ZBC-QRLA/QRLA/README.md

# QRLA

这是重庆大学CRTC(2026） **QRLA战队** 的备赛文档仓库。

>这里记录我们从那天被几个战队拒绝后的心气组队到努力备战希望通过中期考核的尝试，希望我们能够通过，得到报销，然后走得更远，后面或许还能记录我们完整的参赛历程。 

## 队伍介绍

|  |  |
| --- | --- |
| 队伍名称 | QRLA |
| 参赛赛事 | 重庆大学CRTC(2026) |
| 参赛组别 | 新生组 |
| 实训战队 | 千里战队 |
| 队长 | 曾斌才 |
| 队员 | 苏古家乐、安文豪、李志杰 |

**分工：**

| 角色 | 成员 |
| --- | --- |
| 队长 | 曾斌才 |
| 电控 / 硬件 | 苏古家乐、曾斌才 |
| 机械 | 安文豪、李志杰 | 

## 文档索引

所有文档均按**机器人设计进度的完成时间点从早到晚**排列(可能是一天/一个任务的一段时间)

| 序号 | 文档 | 阶段 | 内容提要 |
| --- | --- | --- | --- |
| 01 | [第一天：环境搭建与工具链配置](docs/start-first-day.md) | 起步 | 队伍分工；学生邮箱与 JetBrains 教育许可；CLion + STM32 工具链配置；机械组fasion安装；非常懵懂地努力的几个小时 |
## 机械建模的建模文件在docs/machine
<span style="color:#888;font-size:12px;">这个格式真的好难调，对着豆包打，少一个空格就弄不出来，还好手机像素够高（本备注写于第二天喵）</span>
