ZBC-QRLA/QRLA/docs/机械组工作报告.md

# 机械组学习&工作报告

## 一.机械设计环境搭建

日期：10月2日至10月7日

1.**活动目的**：完成3D设计的软件下载并构建一个高效、规范、协同且安全的数字化设计工作平台，让设计工作能稳定、高质量地开展，同时完成软件常用功能的学习，为后面3D设计机械臂及整车的模型设计打下基础。

2.**预期过程**：3D设计环境搭建→草图功能学习→二维到三维转变的功能学习→装配体功能学习→简单零件的建模跟练。

3.**预期结果**：能够根据实体进行建模，能完成装配体的动画演示。

**活动历程**：

1.Fusion360的安装: 对比了多款主流的3D建模软件选择了Fusion360并进行安装。原因：Creo / NX / CATIA更适用于高端复杂场景，SolidWorks作为最稳妥的主流选择。钣金模块成熟直观，折弯系数、展开图生成都很准，但是价格较高且云端协作能力差，不方便队友之间实时共享进度，Fusion 360的个人非商业用途免费，安装简单，集成了CAD/CAM，对新手友好。

>遇到问题：教育许可版本申请不下来且咨询学长并根据各平台教程多次申请未果。

>解决方法：选择个人非商业用途版并在后期调试时确定其可以满足本次赛事需要。

2.Fushion360的功能学习：根据b站博主“罗大富Bigrich”的教程学习，掌握草图绘制的技巧，能灵活使用中心矩行，两点园等，基本掌握参数化建模和对成品的修改，学会简单的装配联接。Q：如何快速创建齿轮？  A：在实用程序的附加模块中选择Super Gear，然后在创建中找到它并调整参数。

3.跟练：从简单立方体到曲面体的建模跟练，基本可以根据实物独立建模。

>潜藏问题：
>
>- 仅停留在软件学习程度，对比赛的要求了解不全面没有考虑CRTC机器人尺寸、球体包络规则约束。
>
>- 对实体材料缺少了解，不确定3D打印能否打印螺纹。
>
>- 没有了解舵机的工作原理，没有给舵机预留孔位的意识。（这一点是在10月115日意识到的）

当时规划的计划：

- 与电控和硬件的同学商议小车的大体外形，确保小车的尺寸和重量在规则要求的范围内。

- 继续学习机械制造的材料如何选择，学习机械组装所需要的工具和相关力学知识以保证后期小车的稳定性和可操作性。

## 二、机械臂设计初步方案

时间：10月7日

提出方案：

方案一：参考2025年工创赛的比赛视频，提出让底座不动，大臂，小臂，夹子动，同时通过小臂360度转动实现将能量方块从拾取到放入机械臂后的储物框的过程。

方案二：减小小臂的旋转度数，让底座旋转，达到和方案一同样的效果。

方案三：将储物筐置于机械臂之前，底座不转动，延长大臂和小臂完成取物和放入框中的动作。

确定方案：

与队友协商后确定用方案二建模。  
>**原因**：方案一对供电安全和舵机精度要求高，舍弃；方案三因为考虑到要拾取地面上的物块，所以对于两臂的长度和两者之间的夹角要求高，需要在车架和储物框都确定后进行测量，综合考虑后，暂定方案二。

## 三、车架设计

时间：10月8日至10月18日

车架安装遇到的问题及解决——在tt马达与麦轮到手之前，我先在网上参考智能小车安装视频，对安装步骤做到心中有数。到手将tt马达与麦轮安装到底盘上之后，发现麦轮与马达之间的连接并不紧密，于是跟商家要了tt马达与麦轮的建模图分析内部结构，发现问题的根源是与麦轮配套的螺丝(M3*25）过长导致，在更换螺丝(M3*20）后，麦轮与马达连接紧密，问题得到解决。

## 四、机械臂设计

时间：10月8日至今

1.目的：实现从地面到距地面300mm处的边长为30mm的镂空立方体的夹取并平稳放入储物框。

2.预期过程：3D打印材料和钣金的选择使用→根据底盘确定底座尺寸→第一次受力分析明确大臂和小臂的分布和两者之间的比例→夹爪的设计→连接关节的设计→机械臂的二次受力分析及减重设计→动画演示→成品试验与迭代

3.预期目标：①Fusion360完成全部零件实体建模，建立装配体，做干涉检查，保证运动时零件不碰撞。

②运动仿真验证：底座旋转、小臂抬降、夹爪开合（张开角度为180度）三个动作无结构卡死；导出各零件3mf用于切片打印。

③能够完整完成一次质量为12.071g的镂空立方体的抓取、搬运、释放。

**活动历程**：

>**第一次设计(10月8日至10月15日)**

· 圆形底座：位于最下方，作为整个机械臂的安装基础，含有第一轴并负责负责整个机械臂在水平面上的左/右旋转（腰部转动），内部预留MG995舵机安装空位。

· 肩部关节：连接底座和主臂，内部包含第二轴。控制大臂的俯仰（前后倾倒）动作。

· 大臂：呈弯曲状的粗壮连杆。做成流线型、内凹的设计来实现保证结构强度的同时减轻重量（拓扑优化），并避开自身的干涉。

· 肘部关节：连接大臂和小臂，对应第三轴。控制小臂的上下俯仰，决定了机械臂的伸展高度。

· 小臂：较直的一段管状半封闭结构。小臂内部留走线空间。

· 小臂旋转：在小臂的末端（靠近手腕处）有一个关节，负责整个手腕部分沿小臂轴线的自转。

· 手腕：图中的灰色紧凑关节包。包含第五轴（俯仰）和第六轴（末端自转）。多轴联动使得末端能够以任意姿态到达空间中的某一点。

· 末端执行器：做平行夹爪结构。它由两个对称的机械手指组成，通过外部的驱动机构实现平行开合，用来抓取方块。

设计问题：①设计时过分考虑减重导致肩部没有给舵机预留出足够的空间。

②整个机械臂需要起码5个舵机来实现各关节的灵活运动，超出规则要求。

③将夹子和能量方块打印出来后发现架子设计的过小，即使做了增大摩擦的处理也无法顺利夹起物块。

由于第一版机械臂问题过于严重，选择推翻重做。

>**第二次设计（10月15日至18日）**

· 基座：最下方是一个方形底板，方形空腔（放MG995）及圆柱形盖子做第一关节（腰部旋转），方形侧边均做圆角处理，减少碰撞磨损的可能。

· 肩部：连接底座圆盘和大臂的深灰色“U型”支架，较厚实，承受了整个大臂和小臂悬伸带来的巨大弯矩，同时留有MG995的安装空间。

· 主臂（大臂与小臂合一）：这是一根单连杆。这大大简化了结构，但也限制了灵活性（受舵机数量限制）。

·腕部：放置MG90，做与夹爪之间的联接

·夹爪：一个设计得相当紧凑的齿轮联动式平行夹爪。可拆解为三个核心部分：驱动基座、传动机构和执行手指。

1. **驱动部分**

>· 小齿轮套在MG90上，作为主动轮。

2. **核心传动机构**

>· 从动轮（大齿轮）：位于正中央。它接收来自小齿轮的旋转动力，它起着“惰轮”的作用，当小齿轮受舵机带洞转动时，它会直接带动与其以榫卯结构结合的左夹爪。因为右侧有一个惰轮，这就使得左右两个夹爪的旋转方向是相反的。一开一合，实现了夹取动作。

>·次从动轮（夹爪上的齿轮）：。当大齿轮旋转时，通过这个小齿轮，改变了动力的输出方向，使得两根夹爪的手指能够实现同步反向运动。

3. **执行手指**

·主体是对称的两个半个篮子，闭合后内部为40mm×32mm的框，侧边均做倒角和圆角处理，便于通过开合实现对立方体的拾取和放下。如图1

潜藏问题：1.齿轮过多，可能导致扭矩过大，需等待具体试验测试。

## 收集框设计思路历程

### 一、需求分析：先明确收集框要满足什么

设计初期，我先没有直接画收集框，而是从赛规、机械臂（已设计好）、物品和车体安装四个方向反推约束。

1. 赛规与车体约束

收集框外廓初定为 110×110×80 mm，投影尺寸控制在车体允许范围内，避免超宽、超高，不能干涉轮系、传感器和机械臂运动。

2. 物品适配需求

收集物品为 30×30×30 mm 立方体，框子内腔必须能容纳整数个物品，并且物品不能从侧壁缝隙或底部漏出。

3. 机械臂适配需求

框口要位于机械臂末端可达范围内，顶部全开口，高度与机械臂大臂相协调，方便机械臂底座从左右两方旋转过程中抓手不会被收集框卡住。

4. 安装与维护需求

收集框通过 M3 螺钉与车体连接，要求拆装方便、孔位统一、维修更换简单。

5. 轻量化与强度需求

小车对重量和重心敏感，框子不能做成实心封闭盒。采用“底板+四侧壁”的开放框结构，减轻重量。

6. 制造需求

使用3D 打印，壁厚统一，在建模设计时特意增大螺孔直径，设为3.2mm，避免打印缩孔后装不上。

### 二、尺寸计算：按 3 cm 物品重新核算

1. 外形与内腔

取外尺寸：

· 外形：110×110×80 mm

· 侧壁厚：4mm

· 底板厚：4mm

2. 容量计算

物品为 30 mm*30mm*30mm的 立方体。

预估共可收集18个立方体。

### 三、结构设计：框子的具体组成

最终结构分为三部分：

1. 底板与四侧壁

厚 4 mm，四角布置 M3 安装孔，与底盘对应孔位相一致。四条棱做R5圆角。

2. 顶部框口

顶部全开口，开口约 106×106 mm，边缘做R5圆角。

3. M3 安装接口

M3 通孔 Φ3.2，沉孔 Φ6.4。孔位做成参数化阵列，方便根据车体底板孔位微调。

### 四、建模与验证思路

建模顺序：

1. 先画 110×110×80 mm 外框参数化草图。

2. 抽壳得到 4 mm 侧壁、4mm 底板。

3. 四角根据底盘现有孔位，测量数据，确定螺孔位置。

4. 做 R5圆角。

5.装配检查机械臂末端包络是否覆盖框口、框体是否与车体/轮系/传感器干涉、M3 螺钉是否可拧入。

6. 导出 STL 前检查最小壁厚、孔是否被圆角吃掉、螺母位是否可安装。

### 五、总结

我的收集框设计思路是：以 110×110×80 mm 外廓满足车体与赛规约束，以 102×102×776mm 内腔保证 3 cm 立方物品的容量，按每层 3×3、两层共 18 个理论容量设计，实际按 15～18 个验证。
