ZBC-QRLA/QRLA/docs/files/一个合理的工具链配置流程 .pdf

# 一个合理的工具链配置流程

（本文仅针对重庆大学CRTC2026校内赛撰写）

## 一些问题

当你准备接触嵌入式，参加校内比赛或是自己做一些东西时候，可能会选择向有经验的高年级同学选 择求助，除了部分愿意帮助你进行线下配置的大好人，大部分高年级同学还是倾向于选择甩一个b站链 接或者直接让你搜索相关视频，例如：
•
Keil v5+MDK-ARM注册机破解教程
•
Visual Studio Code与Keil工具链配置教程
•
STMCubeIDE配置教程

然后就让大家自己去尝试学习配置相关软件时，更多时候作为一个新入学的嵌入式新人，在你过去十 几年求学生涯中，90%的人可能并没有被引导学习过相关的知识，于是必然需要头铁去啃那些的视 频，更不必提用百度网盘，QQ群文件等下载一堆来路不明的软件。就我个人看来，这种方式是极其不 合理的，虽然在一定程度上筛选了一批对于PC操作不敏感的学生，但是也断绝了一部分对于理论设计 有意识的人的热情。

因此为了抹平配置问题这一壁垒，对于重庆大学千里战队的梯队成员，抑或是参与校内相关比赛前来 学习的非队员同学甚至是校外人士，我们立志提供一份有别于网络上其他同质化教程的快捷配置方 案。

## 一套办法

作为一名合格的大学生，通过正规手段获取生产工具是一项必要的技能。

也许大家看过诸如“付费解锁”“限时秒杀”WinRAR， VScode等软件的梗图，但是在这里我们一定 要达成的共识是，本科阶段学习过程中你使用到的90%的工科软件都有免费获取的途径，因此在下文 我们会引导大家怎么去下载这一内容。

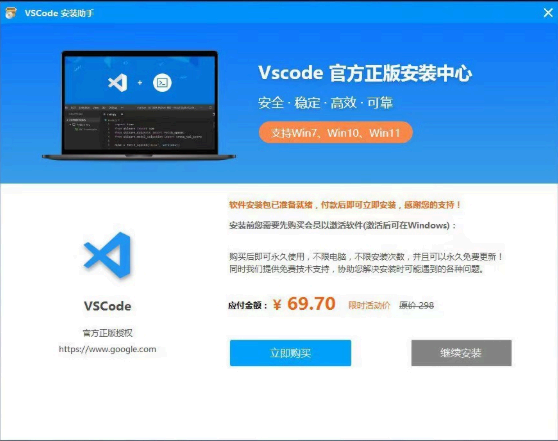
[picture p1: figure]

## 注册重庆大学学生邮箱

作为重庆大学的学生，带有“学号+stu.cqu.edu.cn”格式的官方学生邮箱是能够辅助证明学生资质的

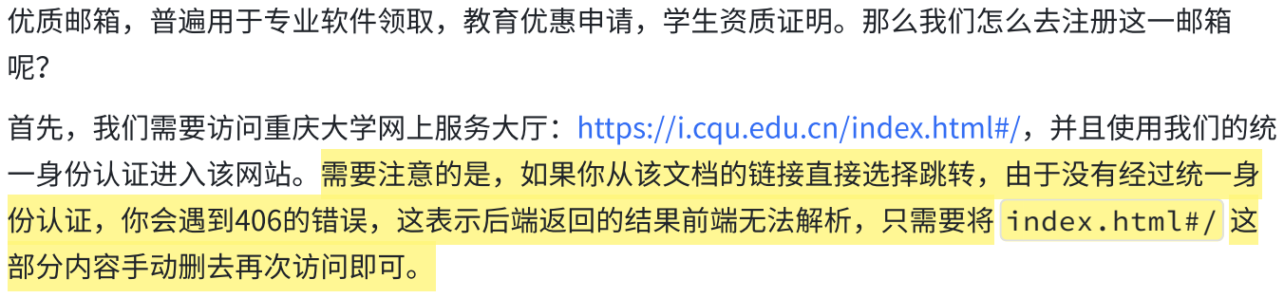
[picture p2: figure]
优质邮箱，普遍用于专业软件领取，教育优惠申请，学生资质证明。那么我们怎么去注册这一邮箱; 首先，我们需要访问重庆大学网上服务大厅：https://i.cqu.edu.cn/index.html#/，并且使用我们的统; 一身份认证进入该网站。需要注意的是，如果你从该文档的链接直接选择跳转，由于没有经过统一身; 份认证，你会遇到406的错误，这表示后端返回的结果前端无法解析，只需要将; index.html#/; 部分内容手动删去再次访问即可。
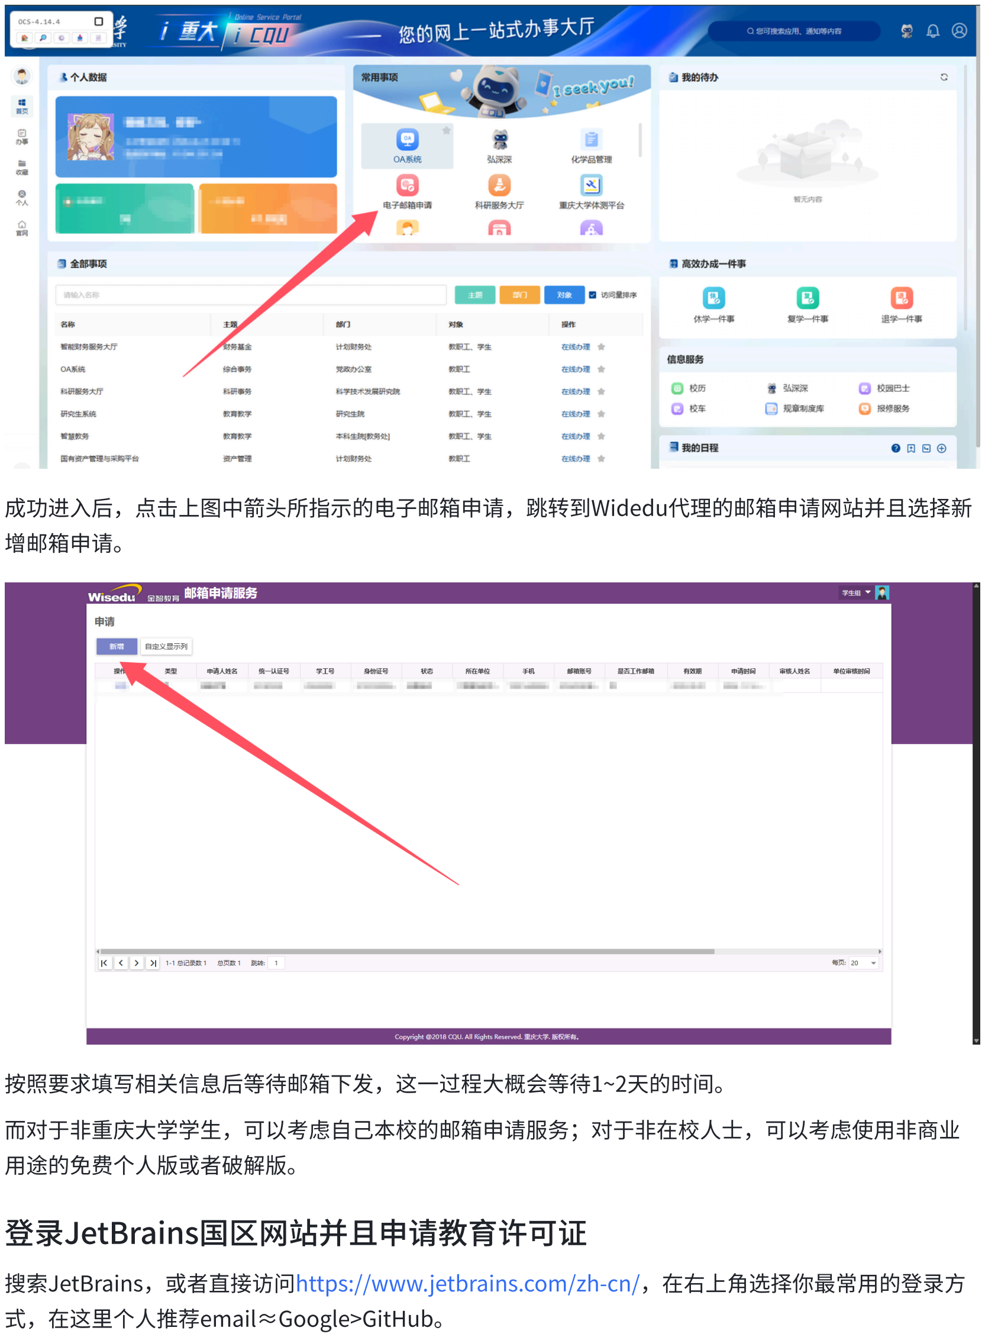
[picture p3: page 3]

成功进入后，点击上图中箭头所指示的电子邮箱申请，跳转到Widedu代理的邮箱申请网站并且选择新 增邮箱申请。

按照要求填写相关信息后等待邮箱下发，这一过程大概会等待1~2天的时间。

而对于非重庆大学学生，可以考虑自己本校的邮箱申请服务；对于非在校人士，可以考虑使用非商业 用途的免费个人版或者破解版。

## 登录JetBrains国区网站并且申请教育许可证

搜索JetBrains，或者直接访问https://www.jetbrains.com/zh-cn/，在右上角选择你最常用的登录方 式，在这里个人推荐email≈Google>GitHub。

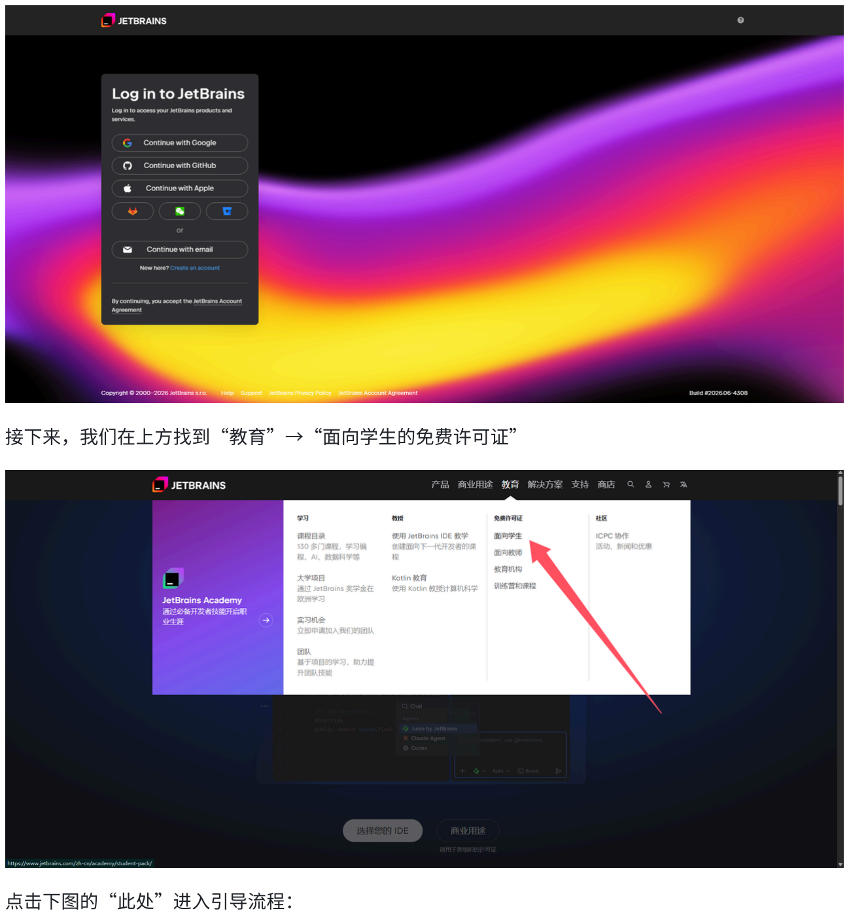
[picture p4: page 4]

接下来，我们在上方找到“教育”→“面向学生的免费许可证”

点击下图的“此处”进入引导流程：

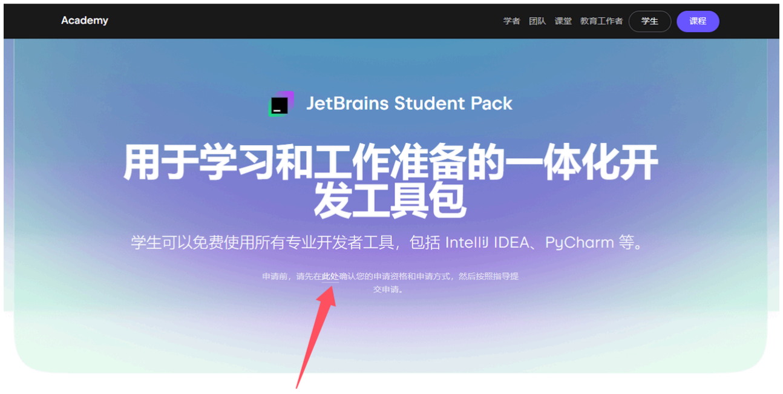
[picture p5: figure]

最后点击“教育授权申请”跳转到申请界面按照要求填写相关信息即可。

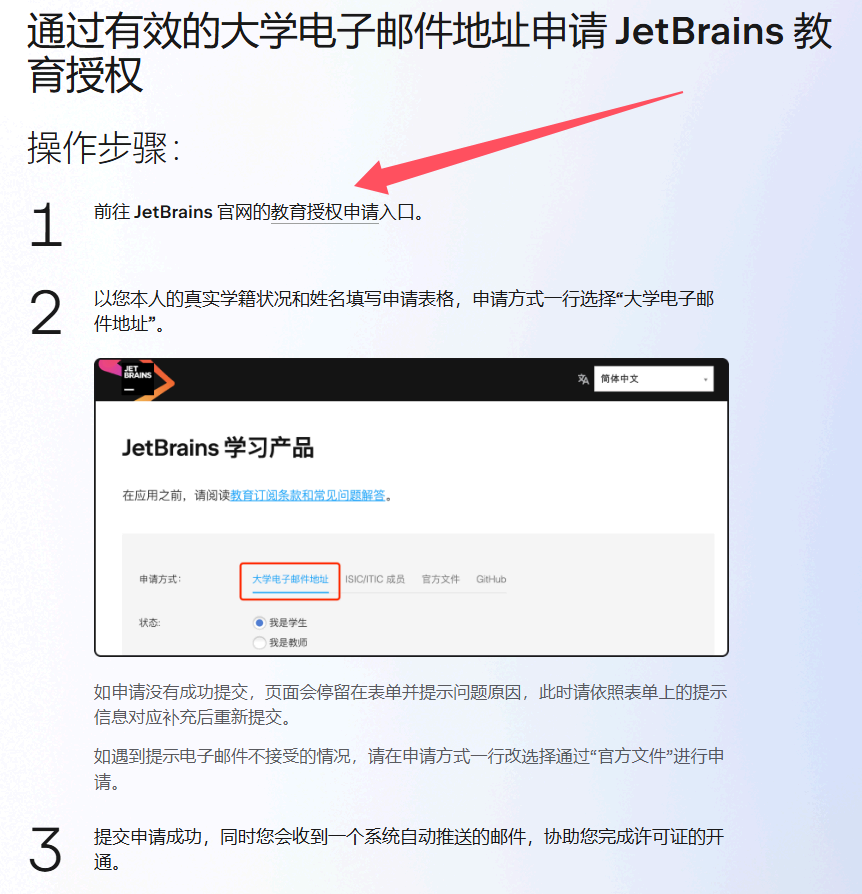
[picture p6: figure]

通过这一步骤成功申请到教育许可证后，我们可以在个人界面看到如下信息：

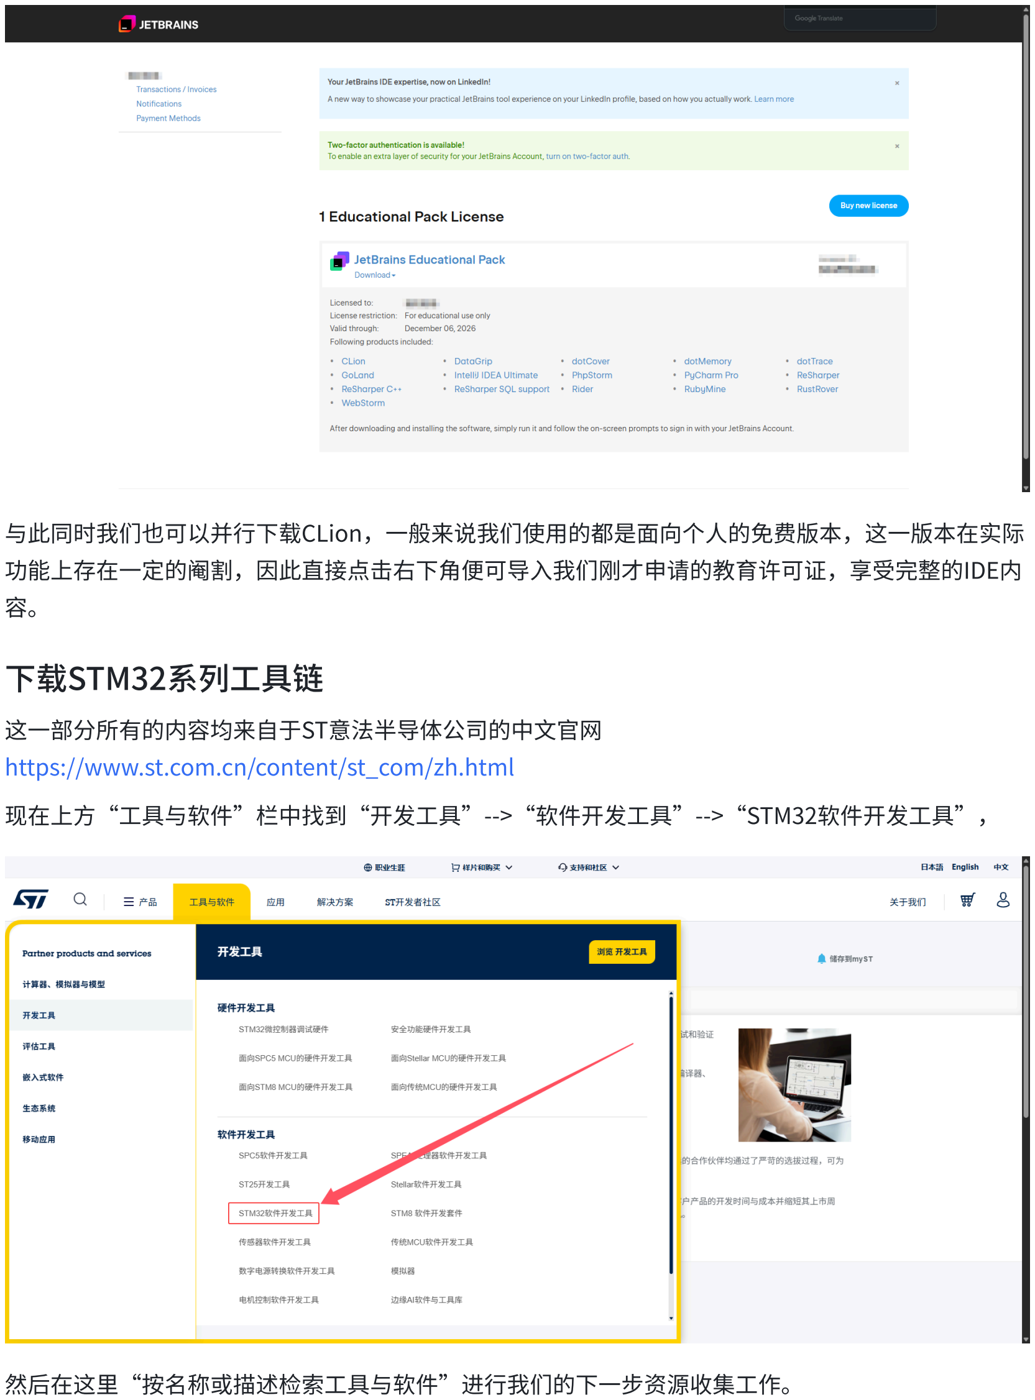
[picture p7: page 7]

与此同时我们也可以并行下载CLion，一般来说我们使用的都是面向个人的免费版本，这一版本在实际 功能上存在一定的阉割，因此直接点击右下角便可导入我们刚才申请的教育许可证，享受完整的IDE内 容。

## 下载STM32系列工具链

这一部分所有的内容均来自于ST意法半导体公司的中文官网 https://www.st.com.cn/content/st_com/zh.html

现在上方“工具与软件”栏中找到“开发工具”-->“软件开发工具”-->“STM32软件开发工具”，

然后在这里“按名称或描述检索工具与软件”进行我们的下一步资源收集工作。

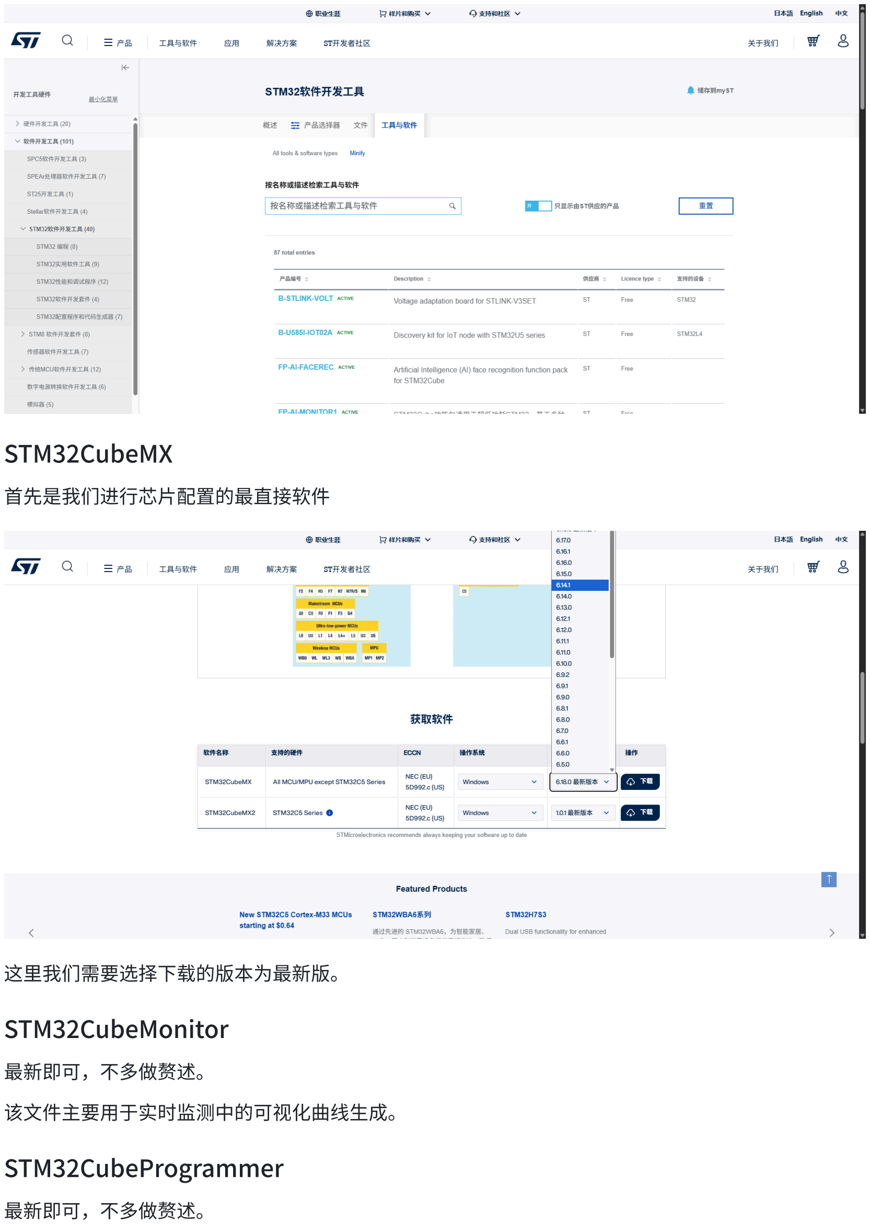
[picture p8: page 8]

## STM32CubeMX

首先是我们进行芯片配置的最直接软件

这里我们需要选择下载的版本为最新版。

## STM32CubeMonitor

最新即可，不多做赘述。

该文件主要用于实时监测中的可视化曲线生成。

## STM32CubeProgrammer

最新即可，不多做赘述。

## STM32CubeCLT

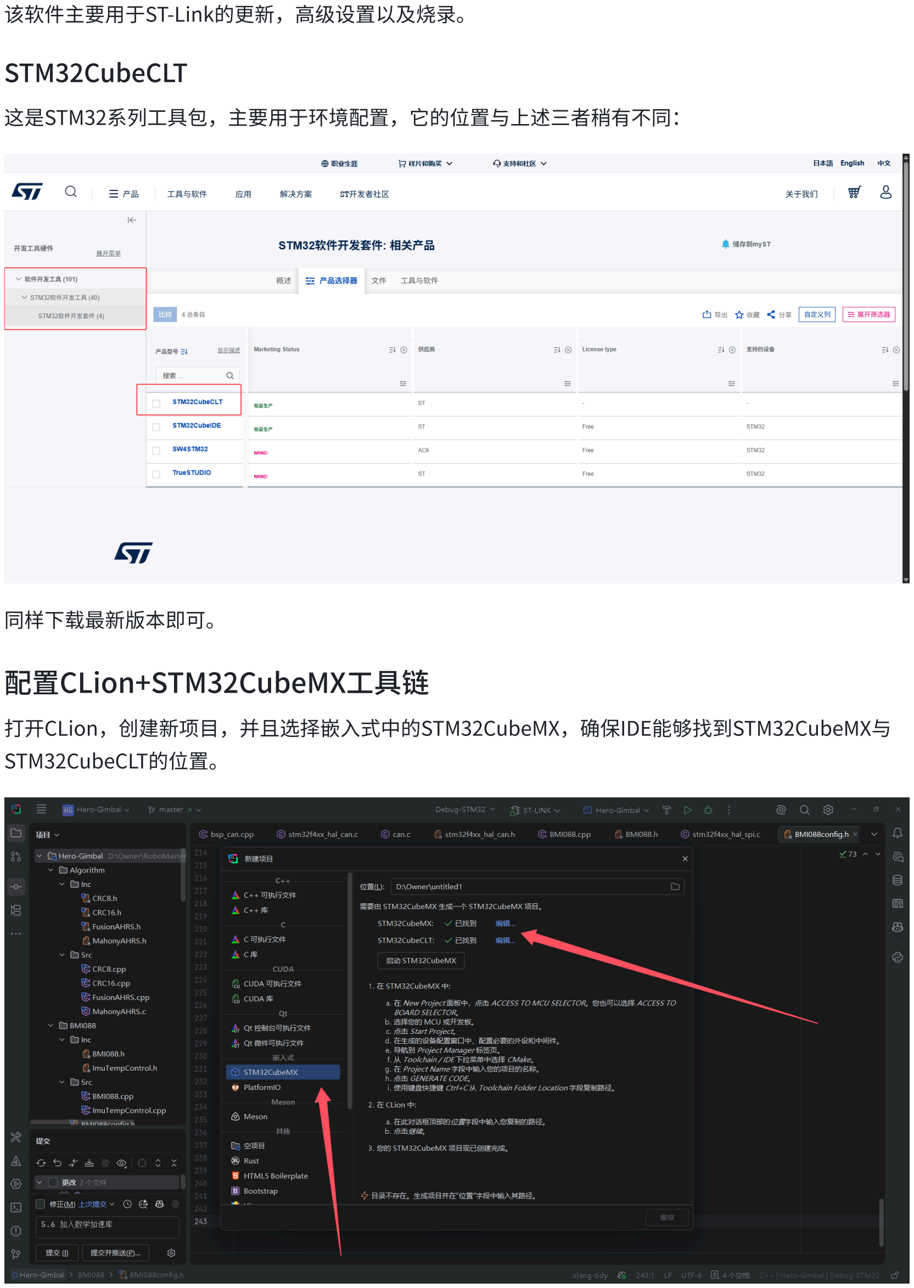
[picture p9: page 9]

该软件主要用于ST-Link的更新，高级设置以及烧录。

这是STM32系列工具包，主要用于环境配置，它的位置与上述三者稍有不同：

同样下载最新版本即可。

## 配置CLion+STM32CubeMX工具链

打开CLion，创建新项目，并且选择嵌入式中的STM32CubeMX，确保IDE能够找到STM32CubeMX与 STM32CubeCLT的位置。

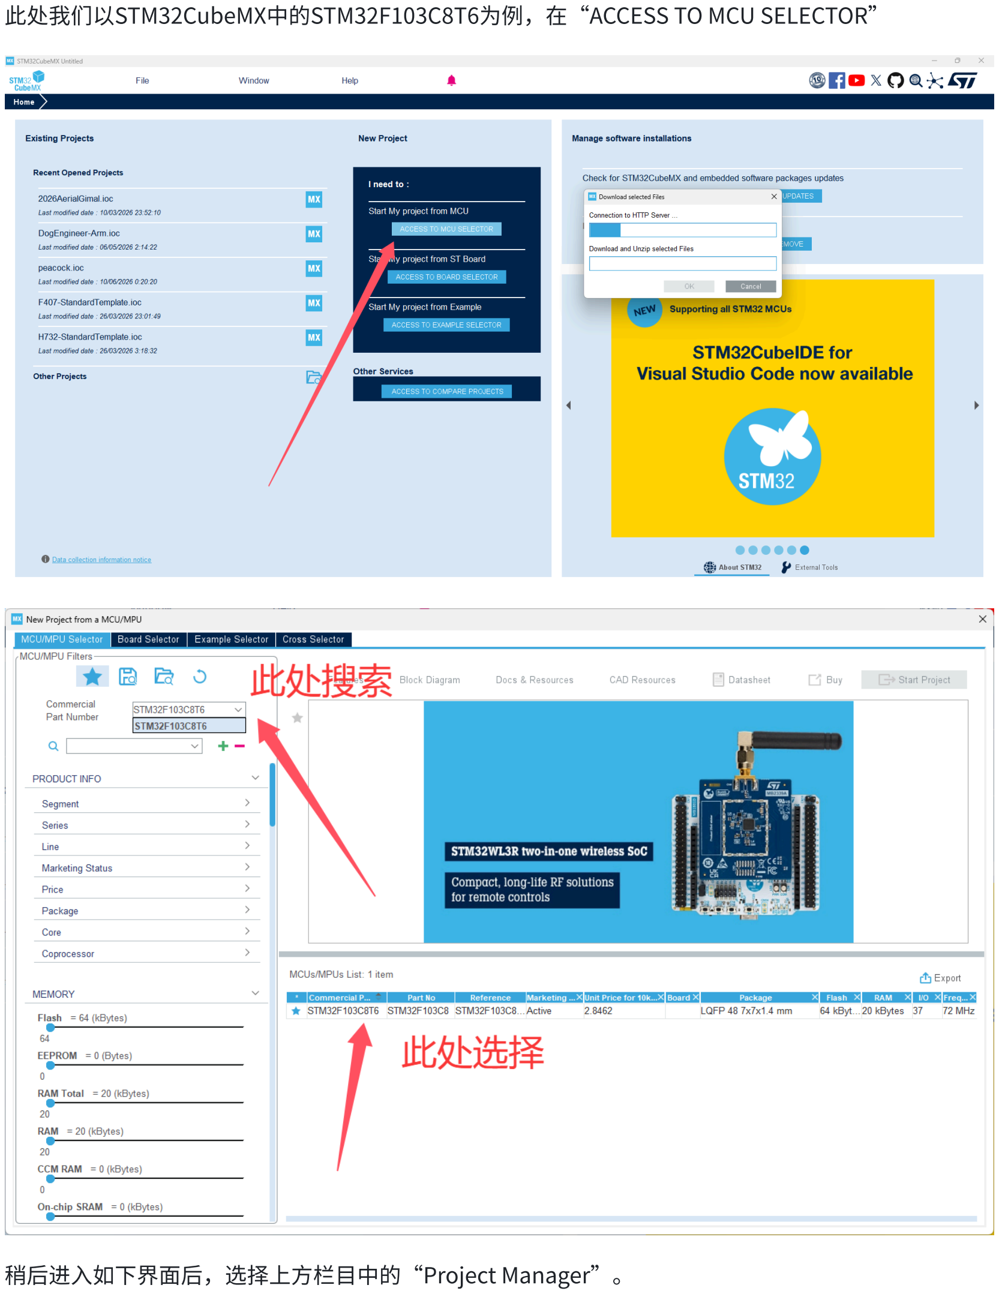
[picture p10: page 10]

此处我们以STM32CubeMX中的STM32F103C8T6为例，在“ACCESS TO MCU SELECTOR”

稍后进入如下界面后，选择上方栏目中的“Project Manager”。

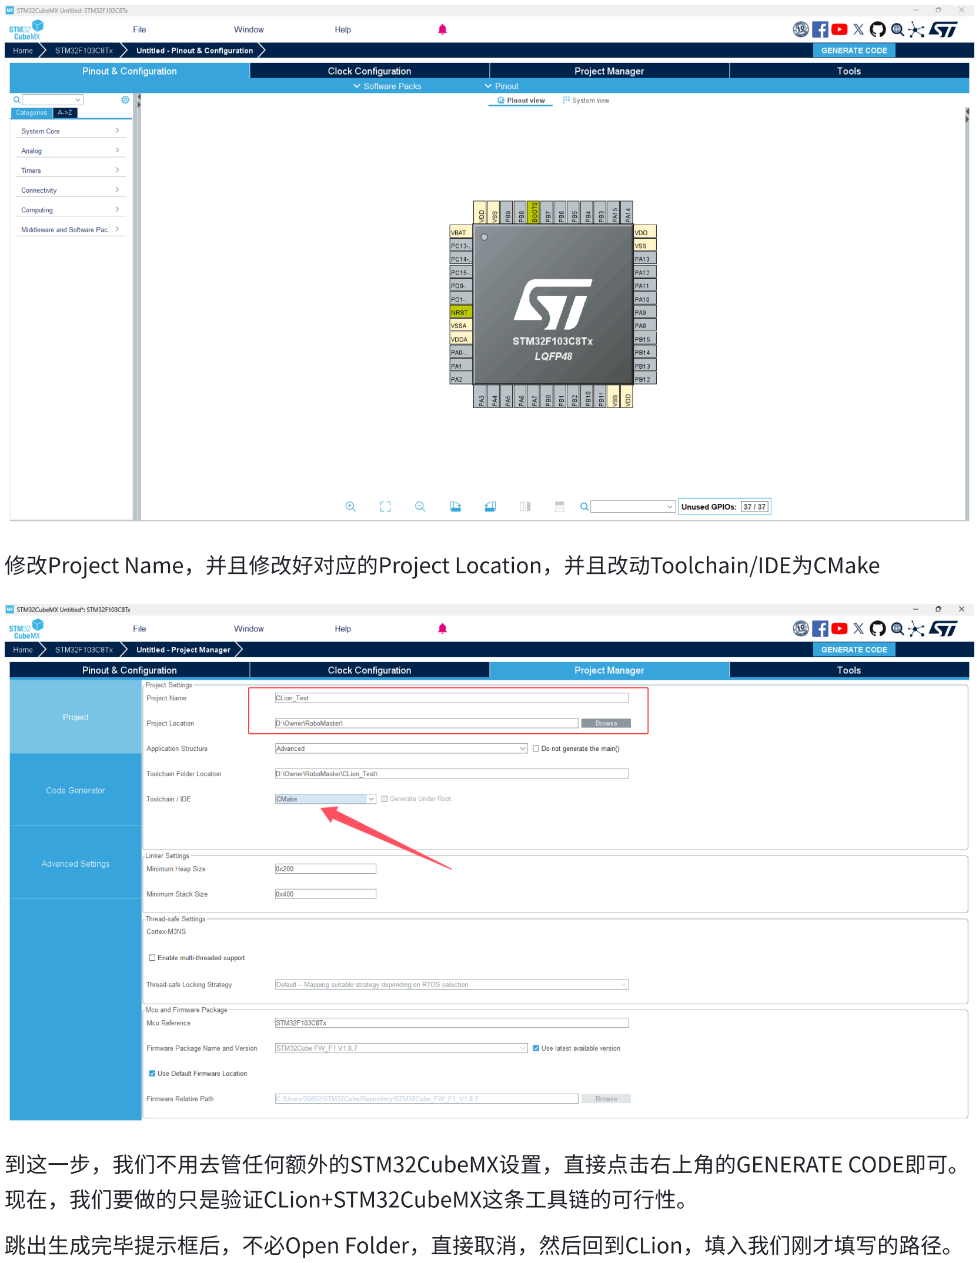
[picture p11: page 11]

修改Project Name，并且修改好对应的Project Location，并且改动Toolchain/IDE为CMake

到这一步，我们不用去管任何额外的STM32CubeMX设置，直接点击右上角的GENERATE CODE即可。 现在，我们要做的只是验证CLion+STM32CubeMX这条工具链的可行性。

跳出生成完毕提示框后，不必Open Folder，直接取消，然后回到CLion，填入我们刚才填写的路径。

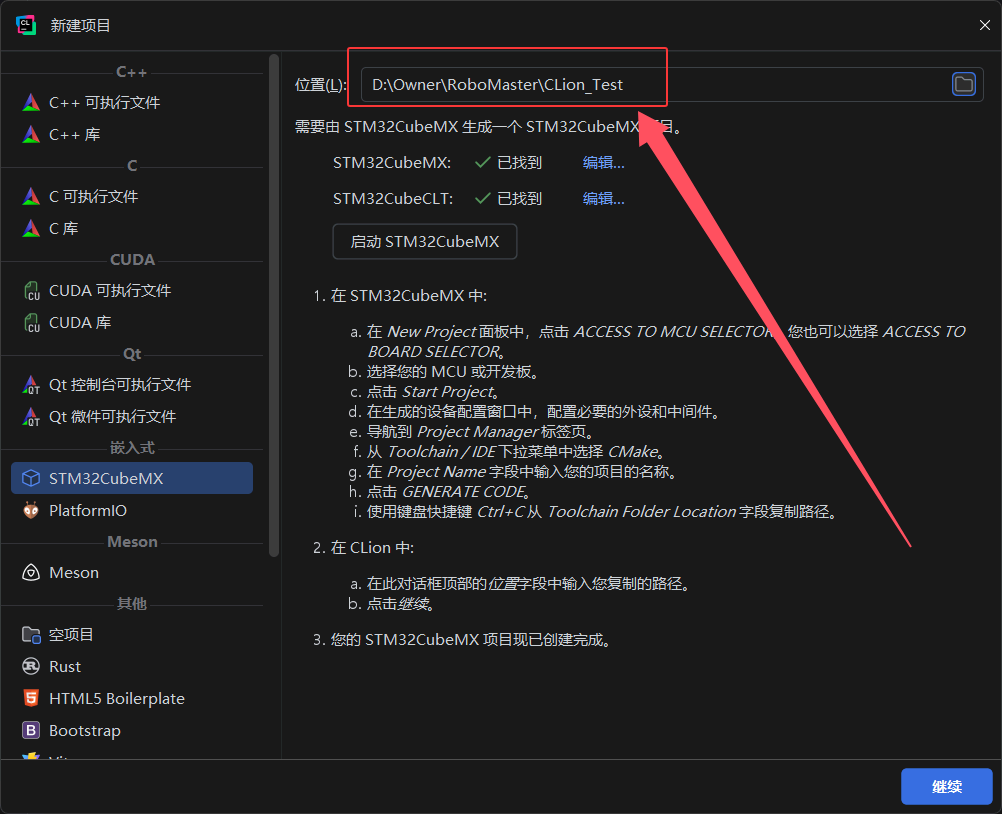
[picture p12: figure]

只要条件完全满足，右下角的继续就会亮起，然后就进入到我们的CLion配置阶段：

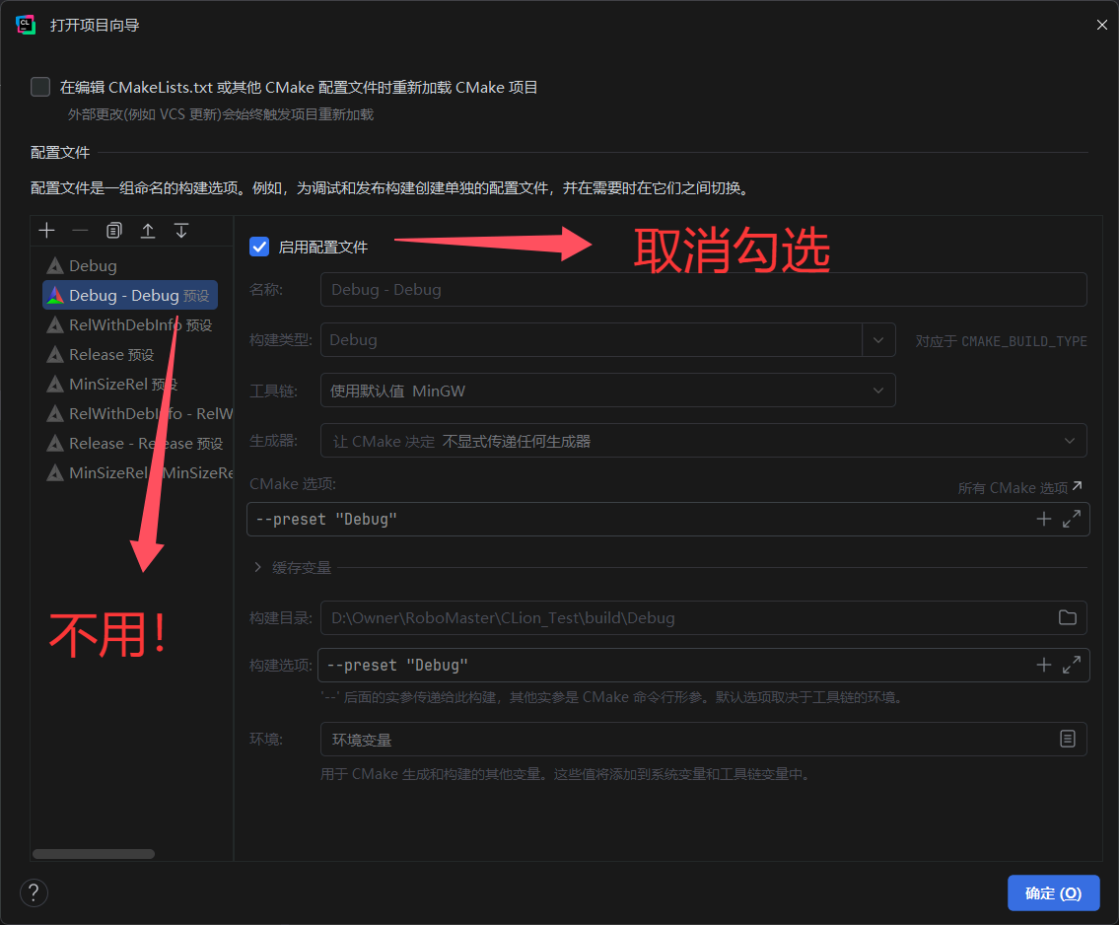
[picture p13: figure]

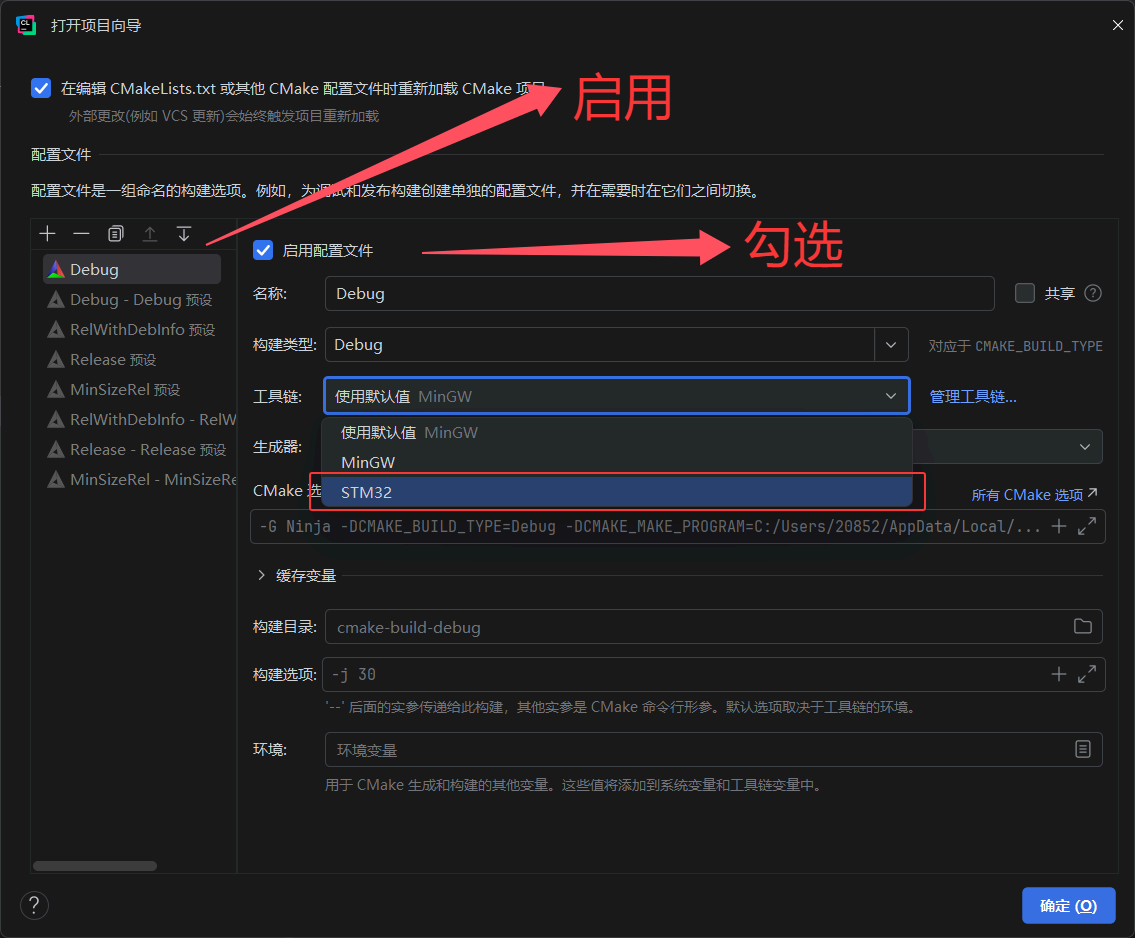
[picture p14: figure]

关于图中STM32这条工具链的切换，就需要我们点击右侧的“管理工具链...”，这时就要请出我们的 STM32CubeCLT了，左侧加号添加系统工具链，然后按照右侧同样的内容改动即可。（下图版本可忽 略）

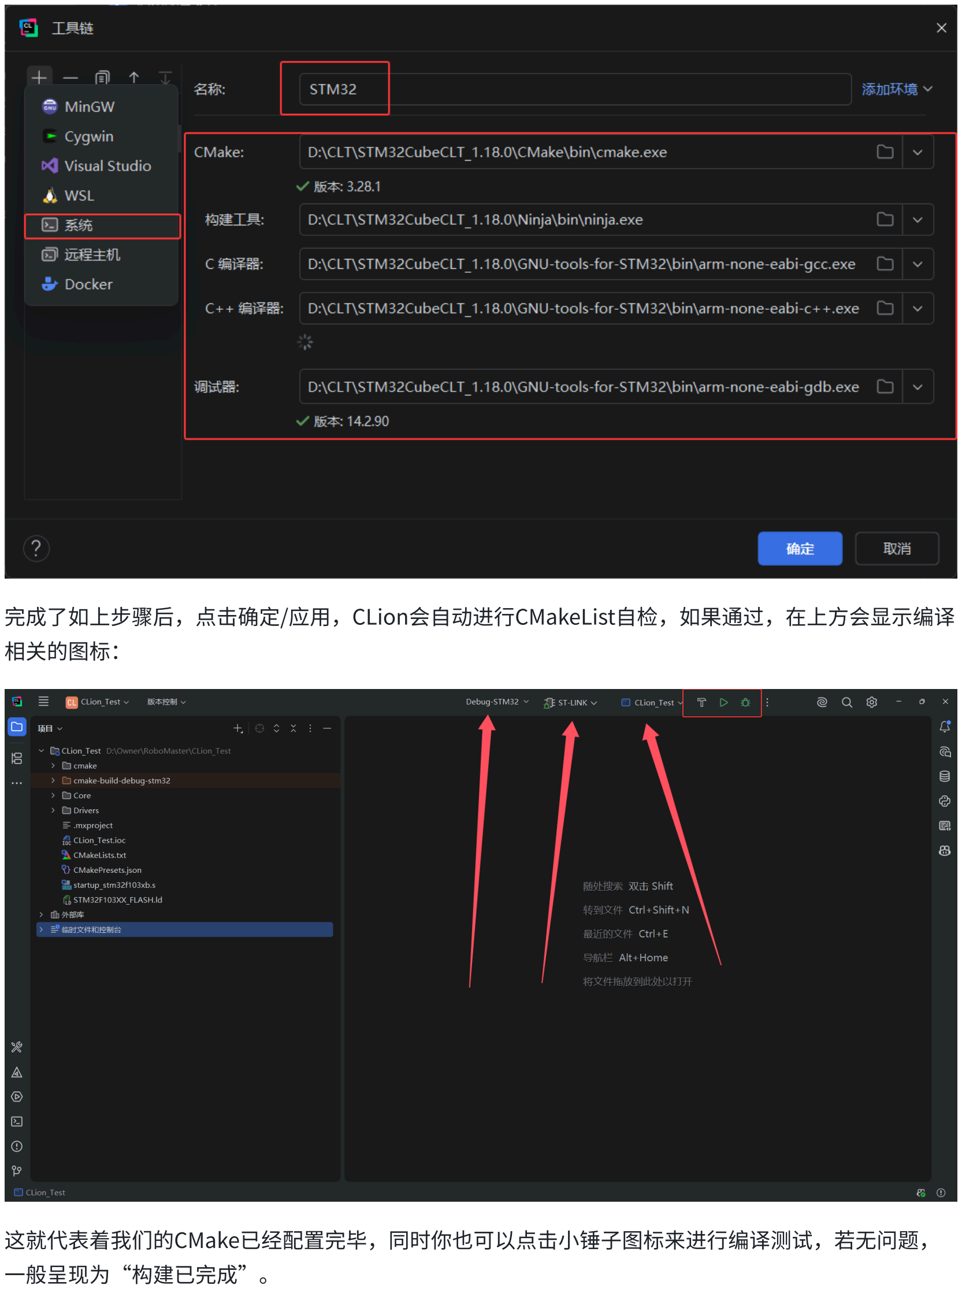
[picture p15: page 15]

完成了如上步骤后，点击确定/应用，CLion会自动进行CMakeList自检，如果通过，在上方会显示编译 相关的图标：

这就代表着我们的CMake已经配置完毕，同时你也可以点击小锤子图标来进行编译测试，若无问题， 一般呈现为“构建已完成”。

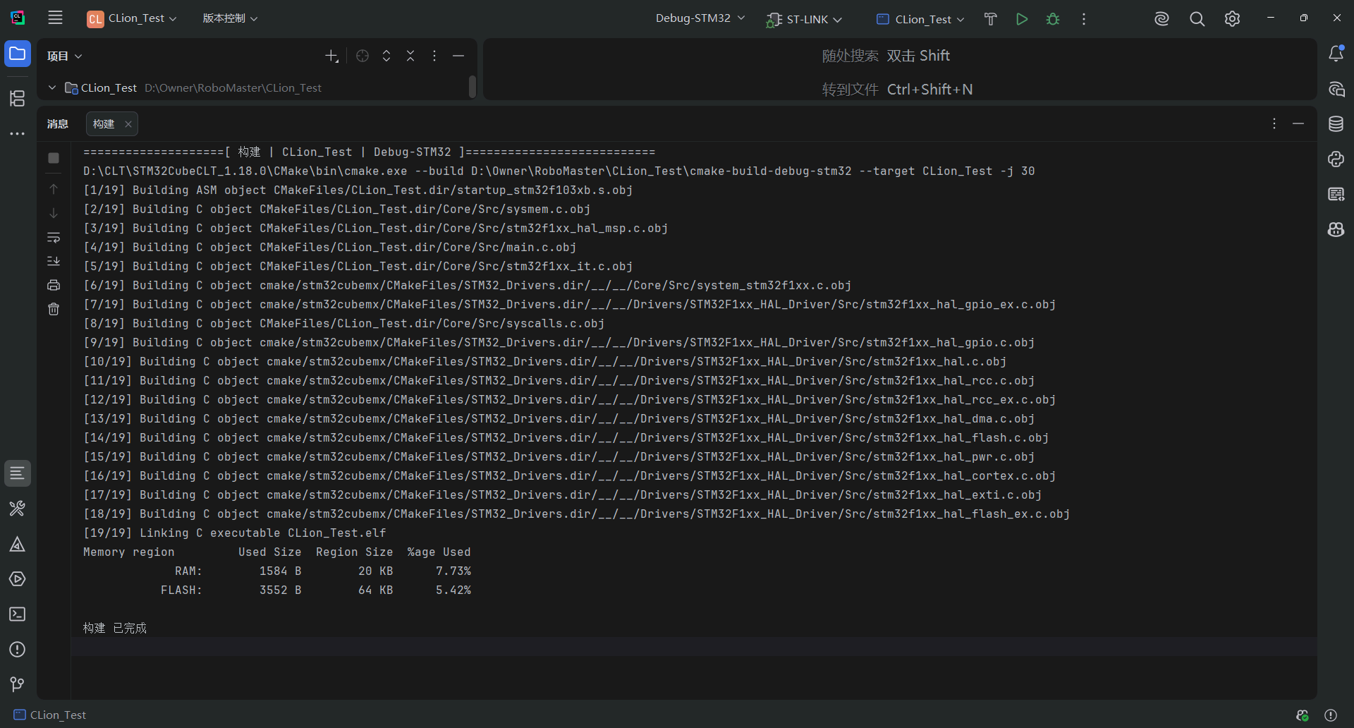
[picture p16: figure]

至此，我们就已经完成了基础的配置。

## 特殊情况

在6.14.1以后的CubeMX版本中，由于新增了对于编译路径的选择，因此在generate code之后有些同 学在进行以上操作会后遇到诸如

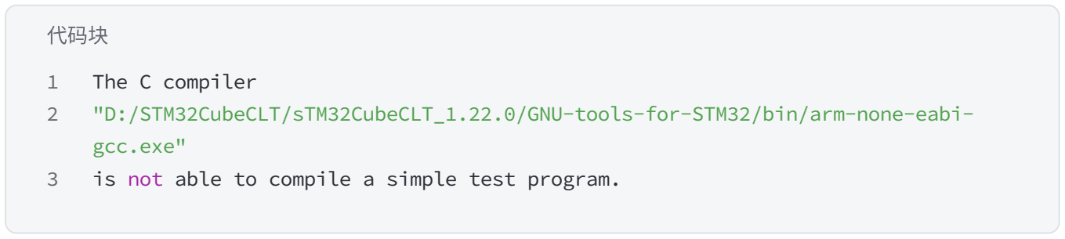
[picture p17: figure]
代码块; The C compiler "D:/STM32CubeCLT/sTM32CubeCLT_1.22.0/GNU-tools-for-STM32/bin/arm-none-eabi- gcc.exe"

is not able to compile a simple test program.

从英文不难看出，它指的是 C 编译器不能够通过一个简单的编译测试。这指的是我们的 Arm 架构编译

### arm-none-eabi-gcc.exe 不能够用于编译CLion提供的一个 C 语言编译程序，解决的方式也很简

单，只要跳过这一次编译，直接指定好我们下载的编译器即可。

即如下图所示，在CMake选项中添加 -DCMAKE_TOOLCHAIN_FILE=./cmake/gcc-arm-none-eabi.cmake即可。

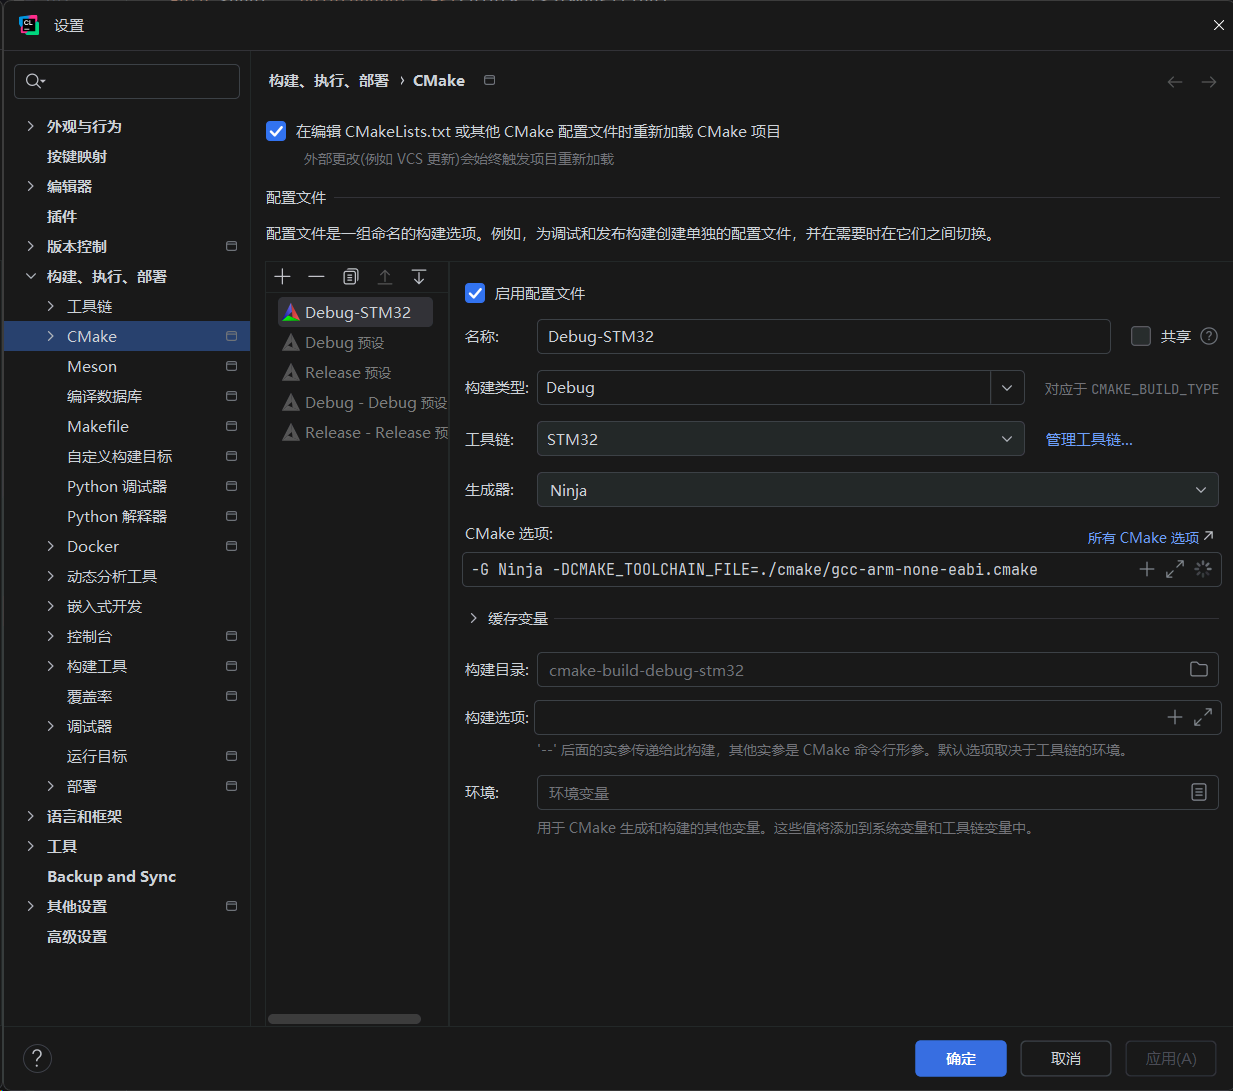
[picture p18: figure]

## 后话：构建完成，然后呢？

至此，我们已经完成了基础工具链的配置。

如果一切顺利，CLion现在已经能够调用STM32CubeMX生成工程，也能够找到STM32CubeCLT提供的 编译工具，并最终在下方告诉我们：

构建 已完成。

看到这五个字的时候，你可能会觉得，我们已经成功完成了第一个STM32工程。

但很遗憾，目前为止，我们甚至还没有真正接触到一块STM32开发板。

倘若你手边有开发板，也请千万不要烧录，由于烧录相关内容目前还没有配置，盲目的烧录会导致单 片机“成砖”，也就是所谓的烧录锁死，相关内容我们会在后面进行补充讲解。

在前面的配置过程中，我们只是以STM32F103C8T6为例生成了一个最简单的测试工程，并借此确认了 下面这条链路能够正常工作：

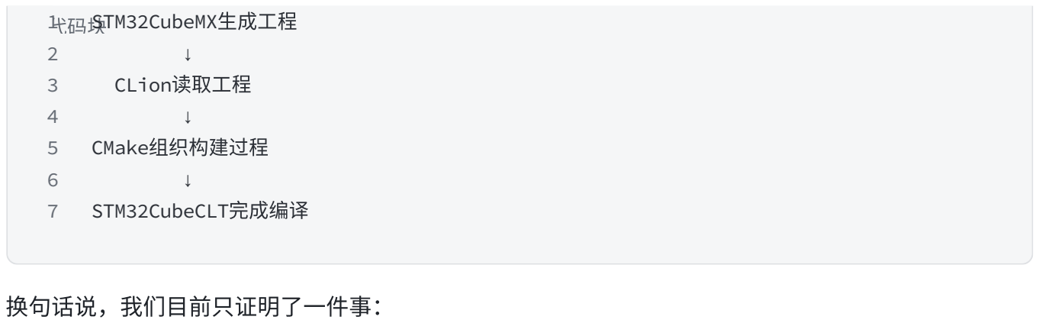
[picture p19: figure]
代码块STM32CubeMX生成工程; ↓ CLion读取工程; ↓ CMake组织构建过程; ↓ STM32CubeCLT完成编译; 换句话说，我们目前只证明了一件事：

电脑已经具备了将C/C++代码转换为STM32程序的能力。

但是，编译成功并不意味着程序已经进入芯片；烧录成功也不意味着程序一定按照我们的想法运行。 想要让一段代码真正影响现实中的硬件，我们还缺少后半段流程：

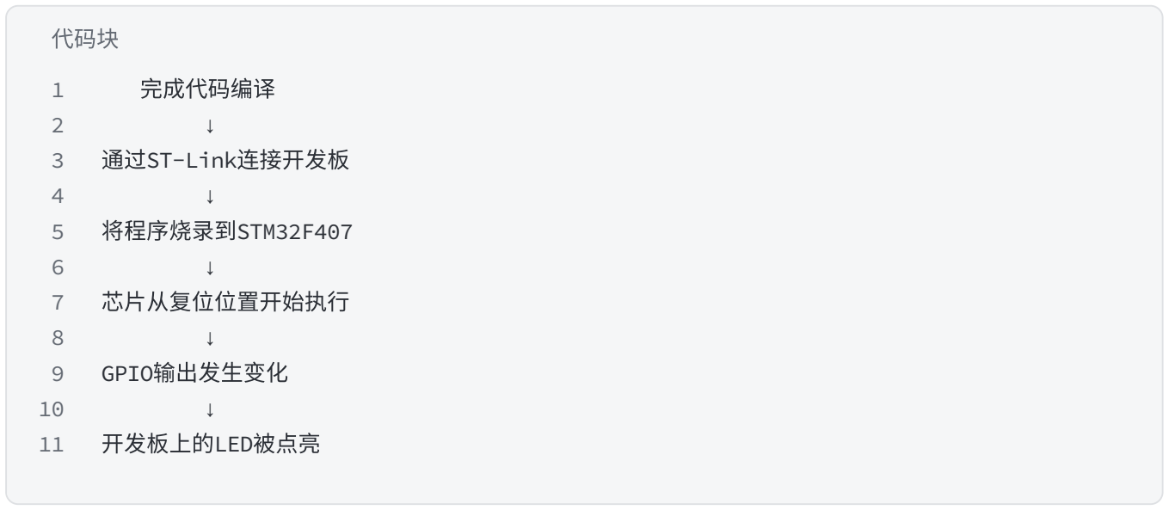
[picture p20: figure]
代码块; 完成代码编译 ↓ 通过ST-Link连接开发板; ↓ 将程序烧录到STM32F407; 芯片从复位位置开始执行 ↓ GPIO输出发生变化; ↓ 开发板上的LED被点亮

在这个过程中，我们还会第一次遇到一些以后经常出现的概念：
•
STM32F407到底是一块开发板，还是一颗芯片？
•
STM32CubeMX中的时钟树有什么作用？
•
为什么需要启用Serial Wire？
•
ST-Link是烧录器还是调试器？
•
编译、烧录和运行分别发生在哪里？
•
CubeMX生成的文件分别负责什么？
•
HAL库为什么能控制一个真实的引脚？
•
如果LED没有亮，我们应该从哪里开始检查？

这些问题不需要在现在立刻得到完整答案，但我们会从下一篇教程开始，通过一次真正的工程实践逐 步认识它们。

下一篇，我们将正式使用本教程的主要入门平台STM32F103C8T6，创建第一个可以编译、烧录、运行 并调试的工程。

我们的目标也非常简单：

先不控制电机，也不接收遥控器，让开发板上的一盏LED按照我们的命令闪烁起来。

点灯虽然被大家调侃为嵌入式领域的“Hello World”，但是如果连灯都点不亮，后面的电机大概也不 会愿意听我们的话。

当这盏灯真正亮起来时，我们才算完成了从代码到硬件的第一次完整闭环。
