ZBC-QRLA/QRLA/docs/start-first-day.md

## 第一天：环境搭建与工具链配置

> 这是我们战队开始的第一天，是小登靠着大佬们留下的参考文件，成功安装好一系列软件后留下的足迹

### 我们做了什么
>因为犹豫很暂时的无知，不敢买器材但努力迈出了第一步：分工和熟悉需要用什么软件

| 分工 | 成员 | 负责方向 |
| --- | --- | --- |
| 队长 | 曾斌才 | 统筹规划、与组委会沟通成员变动/材料购买等问题 |
| 电控组 | 苏古家乐、曾斌才 | 学习STM32相关知识，后续进行嵌入式开发学习并调试机器人 |
| 机械组 | 安文豪、李志杰 | fasion软件学习，后续进行小车机械结构设计与学习|

由于对比赛认识不是特别清晰，后续我们商量在**10 月 3 日召开一次线上会议**，用来对齐整体进度与后续安排。

### 主要记录电控组遇到的困难与解决

**困难：网络访问**—— 配置过程中最大的阻碍不是软件本身，而是网络——STM32 工具链需要从 ST 意法半导体官网下载，JetBrains 许可证申请与 CLion 安装也依赖境外站点。在直连状态下，直接无法下载，页面加载中断的情况反复出现，安装到快要绝望。。。

**解决**:还好学长们给出的参考文件里有VPN下载的网址，于是我们先安装了VPN工具（魔戒），让 ST 官网与 JetBrains 站点能够稳定访问。网络通了之后，后面"申请许可证 → 下载工具链 → 配置 CMake"这几步才得以顺利完成。

<span style="color:#888;font-size:12px;">然后去注册谷歌账号等网站玩耍浪费了几个小时（）</span>

### 结果与验证

参照工具链文档的做法，我们以 `STM32F103C8T6` 为例走通了一次完整验证：CubeMX 中选择芯片 → `Project Manager` 中把 Toolchain/IDE 改为 `CMake` → 生成代码 → 回到 CLion 填入工程路径 → 在"管理工具链"中把工具链指向 STM32CubeCLT 的编译工具。

点击小锤子编译，CLion 返回"**构建已完成**"。

### 参考资料

诚挚地附上我们伟大的 CRTC 组委会提供的入门文档。

> **感谢 CRTC 组委会提供的文档入门参考，小登狠狠谢过了。**

- [如何开始（How To Begin v2.0）](files/How%20To%20Begin_v2.0%20%283%29%20%281%29.pdf)
- [一个合理的工具链配置流程](files/%E4%B8%80%E4%B8%AA%E5%90%88%E7%90%86%E7%9A%84%E5%B7%A5%E5%85%B7%E9%93%BE%E9%85%8D%E7%BD%AE%E6%B5%81%E7%A8%8B%20.pdf)

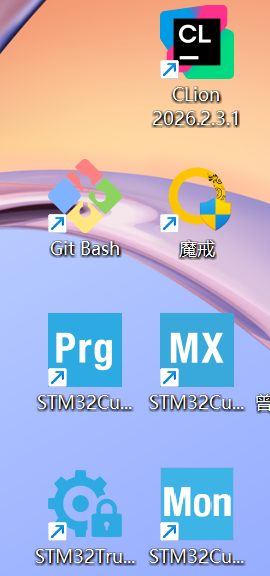
[picture p21: docs/images/install-day.png]
第一天环境搭建完成后，桌面上的工具链已经各就各位
