ZBC-QRLA/QRLA/docs/purchase-plan.md

## 采购日程
> 在这里我们会记录下各个阶段，我们都购入了什么，花销的金额，以及为什么会这样买

### QRLA第一次采购
* **日期**：10月3-10月4
* **过程**：队长曾斌才在10月3号中午先转发了DSH提供的对官方物资的分类表（分为电控和机械两组），随后在晚上8点队员们进行了1h30的线上会议。会后，电控组和机械组的同学分别进行私下交流，最终由队长统一下单
* **开销**：第一批采购总金额控制在267.67元（其中电控165.49元，机械102.18元）

### QRLA第二次采购
* **日期**：10月7-10月9
* **过程**：队员们在10月7号进行了第一次线下会面，商讨了后续机械臂设计的方案初步设想，虽然最后因为不熟悉导致沟通效率低下，但还是筛选出舵机数量不够等问题，并且萌生了想要提前准备第二辆车材料的想法（尽管不一定能通过中期考核）
* **开销**：第一批采购总金额控制在218.38元（其中电控110.62元，机械107.76元）

## 采购标准

1. **官方物资优先**：因为看懂赛事规则表中只有新生组允许使用表外物资，所以打算采购标准物资；一方面我们是零基础，初期连是否采购物资都感到非常迷茫，最后我们决定按照传统的经典流程进行学习，以学习技术并了解开发流程为第一目的，比赛第二；
2. **安全备用**：第一次采购开始我们就采取了进行了冗余采购，如将开发板多买两个，驱动模块多买两个备用（当时还没决定做第二辆车，怕连第一辆车都完成不了）；//虽然目前没有任何器件损坏，除了队长焊接的时候烫到了自己的手（）

## 报销物件的决定
### 整机成本预算（单台车 BOM）

**每台车**，按采购单实际单价（电池按 82.90 ÷ 4 = 20.73/节）；共用设备（调试器、手柄、充电器、机械臂/马达组装器件等）与耗材不计入单台。

| 部件 | 数量 | 单价 | 小计 |
|---|---:|---:|---:|
| STM32F103C8T6 核心板 | 1 | 12.33 | 12.33 |
| DRV8833 驱动模块 | 2 | 2.15 | 4.30 |
| DC-DC 5V 降压 | 1 | 2.42 | 2.42 |
| TT 马达 1:48 | 4 | 2.83 | 11.32 |
| 60mm 麦轮（4 个/套） | 1 | 38.80 | 38.80 |
| 4 轮金属底盘（折弯板） | 1 | 14.20 | 14.20 |
|4轮金属底盘平板（无马达孔）|1|8.30|8.30|
| 18650 动力电池 | 2 | 20.73 | 41.45 |
| 18650 电池盒（2 节） | 1 | 3.39 | 3.39 |
| 面包板 400 孔 | 2 | 2.00 | 4.00 |
| 舵机（MG995×1 + SG90×2） | 3 | — | 26.30 |
| **单台合计** | | | **166.81** |

**两台车**合计**333.62**，再加上后续的两个手柄和无线继电器，总价略超；但由于队长是电控的，表示手柄想留一个自己耍，最后申报时会将报价控制的极为接近400元；

附件：- [采购具体清单](data-form/QRLA采购清单.xlsx)
