ZBC-QRLA/QRLA/docs/machine/机械臂臂体设计.3mf

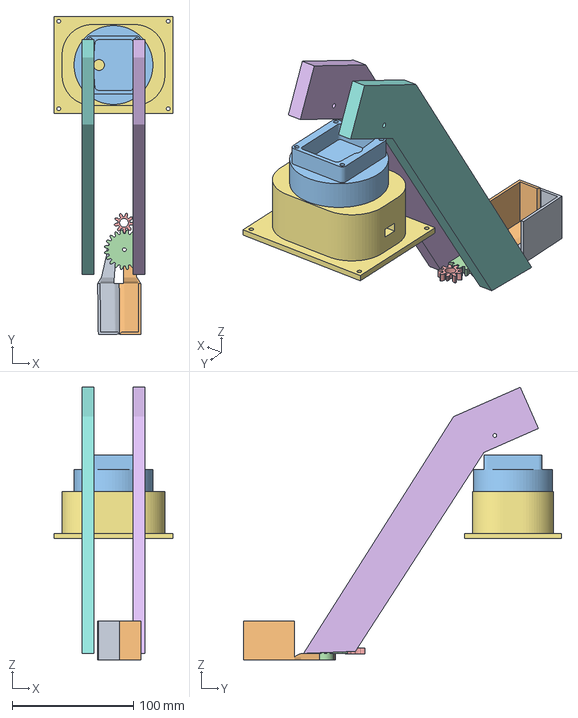
[picture p22: CAD file, 2026-10-19]
docs/machine/机械臂臂体设计.3mf
98.0 x 262.3 x 224.8 mm
实体1 x 7
实体2
