ZBC-QRLA/QRLA/docs/machine/机械臂爪设计.3mf

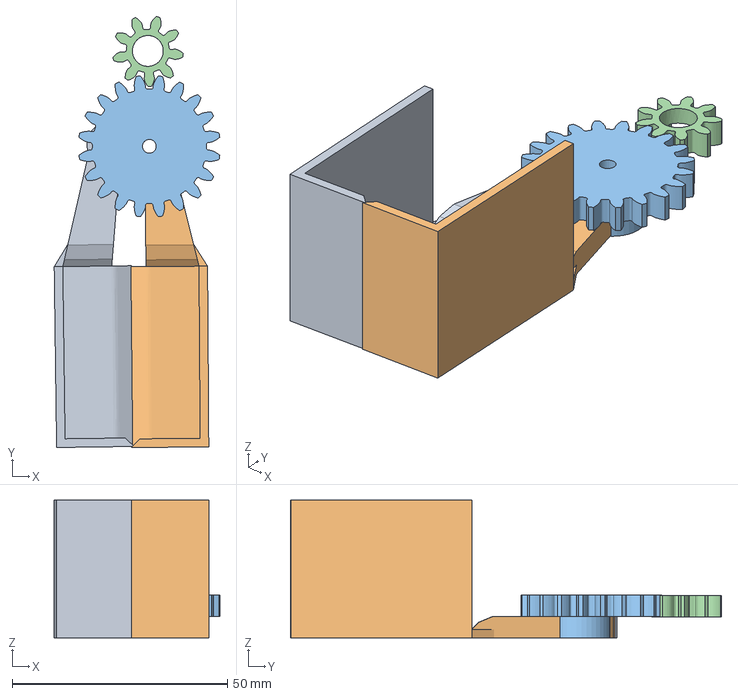
[picture p23: CAD file, 2026-10-19]
docs/machine/机械臂爪设计.3mf
38.5 x 100.1 x 32.0 mm
实体1 x 4
