ZBC-QRLA/QRLA/docs/machine/机械臂失败设计1.3mf

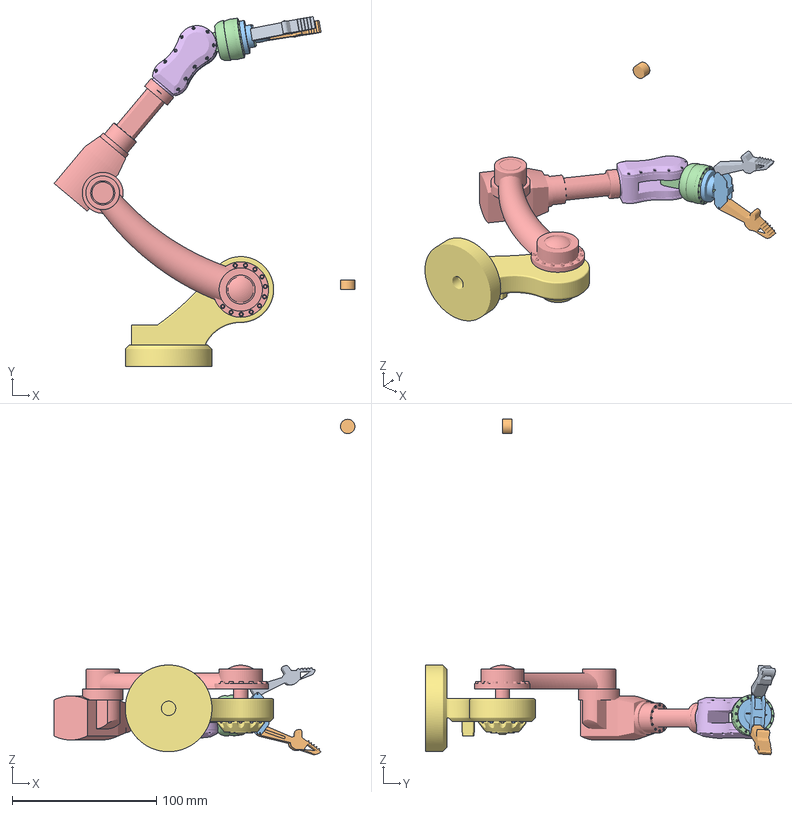
[picture p24: CAD file, 2026-10-19]
docs/machine/机械臂失败设计1.3mf
208.3 x 242.4 x 232.4 mm
实体1 x 7
实体10 x 4
实体11 x 4
实体12 x 4
实体13 x 4
实体14 x 2
实体15 x 3
实体16 x 2
实体17 x 2
实体18
实体19
实体2 x 4
实体20
实体21
实体22
实体23
实体24
实体3 x 5
实体4 x 4
实体5 x 5
实体6 x 4
实体7 x 4
实体8 x 4
实体9 x 4
