ZBC-QRLA/QRLA/(list of files, cad)

Other CAD files:
docs/machine/机械臂臂体设计（另一种后缀的文件）.step
