ZBC-QRLA/QRLA/docs/电控开发日志.md

# 电控开发日志 （QRLA / 2026 CRTC 中期考核）

> 工具链 ：CubeMX + CLion + CMake；板子：STM32F103C8T6；    
> 时间:2026年10月3日 → 2026年10月18日；      
> 努力目标：完成《2026CRTC 参赛手册 V1.5》里电控直接任务中的指标。

当10-03 我第一次让 CLion 的「构建已完成」出现在屏幕上；当10-04 时我还在对着AI说「教程我都看不懂，CLion 我都没搞明白」，我一路都很忐忑，而这份日志记的是从那之后到 10-18 的十五天：从点亮一颗灯，到 PS2 手柄能读出摇杆，让车子能在地上跑。

到 10-18 收工时的指标状态：

| 指标 | 内容 | 状态 |
|---|---|---|
| 2 | 电机运动（单一） | 10-13 转 / 10-15 能停住 |
| 3 | 电机运动（全部，≥4 个） | 10-17，4/4 实测 |
| 4 | 舵机运动（单一） | 10-18控制角度 |
| 6 | 底盘运动（单一，PS2控制） | PS2 能切换数字模式摇杆操控车子 |
| 8 | 尺寸规范 | 根据实际测量加上，模型设计估算未超过|
| 11 | 结构稳定性| 从200mm摔下去也没事呢，虽然还没加机械臂，但我们也还没改成后续的PCB板和加固结构，认为不会有大问题 |
| 12 | 采购单 / 选型预算 | 已有清单 |

---

## 1. 点灯 + 按键：把「编译→烧录→看现象」走成闭环
**日期**：2026年10月7日

**功能描述**：让 PC13 上的板载 LED 闪起来；

**开发历程**：
- 根据教程一步步设置了STM32F103C8T6的引脚，第一次烧录了具体的代码进去，至今还记得当时接ST-link的小心翼翼，结果复习的时候发现只是GND对GND，K对K，O对O；
- 看到小灯亮起的时候没有兴奋，更多的是害怕：怎么那么复杂又脆弱，好怕哪里不对就烧了；
- 后来打了消抖的测试代码，虽然没有用上，不过也第一次让我感受到不是代码怎么想，硬件就怎么动的。。。被折磨了一天

**经验总结**：
- 上电前就该有预期现象。**先说出预期，再看现实**，比反过来好判断。
- 硬件要实测了才知道代码是什么效果

---

## 2. 串口打通：`_write`、行缓冲和会变的 COM 号
**日期**：2026年10月8日 ~ 10月10日

**功能描述**：把 USART2 打通，让 `printf` 能把字打到电脑上 —— 从此我可以看到代码运行时的状况

---

## 3. 时钟配到 72MHz
**日期**：2026年10月10日

**功能描述**：把系统时钟从内部 RC 切到外部 8MHz 晶振，PLL 倍频到 72MHz，并用串口实测验证。

- **时钟TIM3选择**：原本想用 TIM2 做 PWM（教程最常见），但 TIM2 默认四脚是 **PA0 / PA1 / PA2 / PA3** —— PA0 被按键占、PA2/PA3 被串口占。最后在AI指导/教训下改选了 **TIM3**（PA6 / PA7 / PB0 / PB1 全空）。
- 其实那个时候还有点懵，不知道PSC71 16999是什么意思，也不知道占空比是什么原理，后来陵龙战队的线上培训教会了我很多。
---

## 4. TIM3 四路 PWM
**日期**：2026年10月11日

**功能描述**：配好 TIM3 四路 PWM，写出 `Motor_Set(id, speed)`，用串口把 7 个测试值的限幅与方向逻辑全验一遍（没有接电机）。

**开发历程**：

- **大坑：7 行 printf 一个字都不出。** 编译成功、烧录成功、串口工具开着、程序在跑 —— 就是**一个字符都没有**。我把 USART 配置和 `_write` 都看了一遍，全对。真正原因是而我的输出结尾漏了 `\r\n`。输出没塞满缓冲区所以没串口输出，这是出现问题之前AI教程所没有提的，虽然它自己的代码没错，但我自己敲的时候敲错了。补上 `\r\n`，全部出现。
- **一个当时的决定：不接电机，只做逻辑验证** ——就是怕电机/驱动板烧了。我真的很谨慎，后来证明对了：那时 `Motor_Set` 还是错的，轮子根本不能反向运作（因为AIN对应的PA6/7当时输入速度的时候，我们0speed没有调，导致BIN对应的PB12/13反向的时候还是1电位，导致此时根本转不起来，只会短暂反向）

**经验总结**：
- AI没办法一下子考虑到所有事情，用AI也不能全盘照抄，很多时候鲸鱼老师检查半天的问题，都是被我自己认真观察or反馈之后才迅速搞定的，motor_set代码的修订就是一个例子，我们仍然需要认真且独立的思考。
---

## 5. 拆模块：不登记 = 死文件，零报错
**日期**：2026年10月12日

**功能描述**：把电机代码从 `main.c` 拆成 `motor.c` / `motor.h`，登记进根 `CMakeLists.txt`，并保证行为与拆分前完全一致。

**开发历程**：
- **为什么拆**：
>- `USER CODE` 里已经混进 PWM、方向、测试循环三件事，再往下加舵机和 PS2 会彻底看不动。
>- 而且在听完陵龙战队的线上培训之后，我也想起了曾经听高中信息学竞赛老师说的工程引用，于是抱着方便+学习的想法，我又让AI生成了拆代码区的教学方案，最后成功实现，真好啊，这样简洁又美观。哈哈哈哈哈哈哈（真的很喜悦啊）

---

## 6. 焊接 + 电机首次转动
**日期**：2026年10月13日

**功能描述**：焊好 DRV8833 排针和 TT 马达引线，第一次通电让电机真的转起来 —— 指标 2。

**开发历程**：
- 这是最累人的一集，焊接不仅消耗了我好几天的时间（因为我不会，所以又慢用小心，自己买的一个刀头还第二天就氧化了！！！），然后还烫到我的手。。
- 我遇到了上文提过的电机不能反转+最后一直转不停的问题，最后让鲸鱼老师（AI）去查了电机的真值表，终于发现代码的问题（当时她还在感谢我，笑哭，虽然也不是第一次了）
**经验总结**：
- 焊完必须先量通断，**两条判据都要**：相邻脚不响（不短路）、线圈线响而对壳不响（通且不漏）。
- 「启动不起来」和「控制错了」是两回事：前者加占空比，后者要改逻辑。**先分清是哪一类。**

- **`CCR` 不等于「力度」。** 「PWM 占空比 0%」≠「这个脚没在起作用」—— CCR 只决定一个脚的高低，**电机转不转、往哪转，是两个脚一起按真值表定的**。
- 遇到「该停不停 / 该转不转」，**先把两个脚的 4 种组合列出来查真值表，再谈 CCR**。
- **`0` 是一个有物理含义的状态，必须显式写出来**：正转 / 反转 / 停，三支都要有。
- 对AI下的判断也要敢于批判，如果不是那天晚上十一点，我超困的情况下还是认真质疑了她的一吨输出，估计我测到死也不知道自己错在哪里了

---

## 7. 四个电机全部转起来：4/4 都是「+80 弱、−80 强」
**日期**：2026年10月17日（上午）

**功能描述**：接上第二个 DRV8833 模块，实测 4 个电机全部正反转可控、`0` 能停住 —— 指标 3。

**开发历程**：
- 就是把线按照第一个电机那样接好（是的，超级乱，如果我们过了中期考核，我一定要去定做一个PCB板），然后把代码弄成用id指向四个电机的循环
- 同时记录了电机在相同电位和speed的情况下的不同转向和转动力度/速度（为以后做准备，但力度不同这个我还没解决来着，还有一点偏还要调）

---

## 8. 供电链路焊完：`OUT+` 还没插，电池盒还没装电池
**日期**：2026年10月17日（夜）

**功能描述**：把降压模块的 4 个焊盘和电池盒焊好、验电通过 —— 但还没真正投入（怕烧了）。

**开发历程**：
- 把硅胶线和针（从杜邦线上面拆下来的）焊接在一起，电池盒也重新焊接了线，无他，怕烧（）
**经验总结**：
- 焊完用电工胶/热缩管保护起来，后来不小心拉了一下让我知道这个做法是正确的，当时吓晕我了
---

## 9. 舵机转起来了：`CCR` 就是微秒数（指标 4）
**日期**：2026年10月18日（上午 ~ 下午）

**功能描述**：CubeMX 配 TIM4 三路 PWM，自己写 `servo.c` / `servo.h`，让 1 号舵机按指定角度转、并且回中位后手掰不动 —— 完成指标 4。

-对开发路程已经比较熟悉了，导致没什么感觉就完成了（感谢鲸鱼老师的辛勤讲解）

---

## 10. PS2 打通 + 锁定配对
**日期**：2026年10月18日（上午 ~ 下午）

**功能描述**：写了 `ps2.c` / `ps2.h`，用软件模拟 SPI 打通接收器，完成「锁定款」配对，读出模式字节、摇杆和 14 个按键。

**开发历程**：
-这部分由于时间特别赶，直接把店家的介绍文档和参考代码给鲸鱼老师读，最后弄出来ps2.c` / `ps2.h（生成了一份协议教程，后续我还需要再学习一下）

---

## 11. 把 PS2 接上底盘（指标 6、7），接电池盒落地跑
**日期**：2026年10月18日 21：00左右
>- 是的,终于敢上电池盒了，当时其他视频都拍了才接的，怕烧持续发力。
- 发现的问题是车子直行有时候会歪，不知道是手柄不小心偏了一点or电机代码没有完全打好or电压不够导致speed设置在40跑不起来导致电机有时候一边的力度会偏小；
## 后续计划
- 组装机械臂与料仓（机械组联系打印还没打印完，可惜了），然后设置机械臂代码
- 调整电机代码，让车子运动的更加灵活
- 学习PCB制板，争取让车子美观简洁而且稳定坚固

---

## 总结

**第一，当前最大的短板是「物理连接的可靠性」，不是算法。**
前十几天（10-03 → 10-12）几乎全在写代码和看串口，一行改对了就是进步；后六天（10-13 → 10-18）每一次「不动了」的原因，几乎**都不在代码里**：杜邦线松了、USB 接触不良、电池盒没装电池、锁定款没锁定、SMD 焊盘没做应力释放、面包板电源轨中间是断的。焊完排针、引线、降压那 4 个之后我才真懂硬件有多烦人：**「能转」和「能一直转」是两件事。**

**第二，第二大的短板是「没时间」。**
从零开始学习到现在，从快十月才临时组队到现在，已经尽力了

**第三，最有效的两个方法。**
一是 **编程文件分区**真的很有效的减少了检查的时间
二是**AI工程窗口交接的设立**：让效率和重复性错误少了很多，学习也更方便了
