ZBC-QRLA/QRLA/docs/code/测试代码/10月18测试手柄连接和转向的代码/main.c

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
/* Includes ------------------------------------------------------------------*/
#include "main.h"

/* USER CODE BEGIN Includes */
#include<stdio.h>
#include"motor.h"
#include"servo.h"
#include "ps2.h"

/* USER CODE END Includes */

/* USER CODE BEGIN PD */
#define PS2_DEADZONE 15
#define SPEED_MAX 80
/* USER CODE END PD */

TIM_HandleTypeDef htim3;
TIM_HandleTypeDef htim4;

UART_HandleTypeDef huart2;

/* USER CODE BEGIN PV */
static const int8_t MOTOR_DIR[4]={+1,-1,+1,-1};

/* USER CODE END PV */

void SystemClock_Config(void);
static void MX_GPIO_Init(void);
static void MX_USART2_UART_Init(void);
static void MX_TIM3_Init(void);
static void MX_TIM4_Init(void);
/**
  * @brief  The application entry point.
  * @retval int
  */
int main(void)
{

  /* MCU Configuration--------------------------------------------------------*/

  /* Reset of all peripherals, Initializes the Flash interface and the Systick. */
  HAL_Init();

  /* Configure the system clock */
  SystemClock_Config();

  /* Initialize all configured peripherals */
  MX_GPIO_Init();
  MX_USART2_UART_Init();
  MX_TIM3_Init();
  MX_TIM4_Init();
  /* USER CODE BEGIN 2 */
  Motor_Init();
  Servo_Init();
  PS2_Init();
PS2_TypeDef pad ={0};
  uint8_t lost=0;
  /*for (uint8_t k = 0; k < 3; k++)          // 轮子标定方向
  {
    for (uint8_t i = 0; i < 4; i++) Motor_Set(i, 80);   // 四轮同号 +40
    printf("calib %u: +40\r\n", (unsigned)k);
    HAL_Delay(2000);
    for (uint8_t i = 0; i < 4; i++) Motor_Set(i, 0);    // 停
    HAL_Delay(1000);
  }*/

//  printf("=== PS2 handshake ===\r\n");
//下部分是单舵机测试
  /*Servo_Set(0,1600);
  printf("servo0 -> 1600us (mid)\r\n");
  HAL_Delay(1000);

  Servo_Set(0,1200);
  printf("servo0 -> 1200us (mid)\r\n");
  HAL_Delay(1000);

  Servo_Set(0,1800);
  printf("servo0 -> 1800us (mid)\r\n");
  HAL_Delay(1000);

  Servo_Set(0,2000);
  printf("servo0 -> 2000us (mid)\r\n");
  HAL_Delay(1000);

  Servo_SetAngle(0,90);
  printf("servo0 angle90 -> 1500us, hold\r\n");
  HAL_Delay(1000);*/
  //下部分是多电机测试
  /*for (uint8_t m=0;m<=3;m++)
  {
    Motor_Set(m,80);
    printf("电机%u 正转+80 dir=%d\r\n",
      (unsigned)(m+1),
      (int)Motor_GetDir(m));
    HAL_Delay(2000);

    Motor_Set(m,0);
    printf("电机%u 停 dir=%d\r\n",
      (unsigned)(m+1),
      (int)Motor_GetDir(m));
    HAL_Delay(2000);

    Motor_Set(m,-80);
    printf("电机%u 反转+80 dir=%d\r\n",
      (unsigned)(m+1),
      (int)Motor_GetDir(m));
    HAL_Delay(2000);

    Motor_Set(m,0);
    printf("电机%u 停 dir=%d\r\n",
      (unsigned)(m+1),
      (int)Motor_GetDir(m));
    HAL_Delay(2000);
  }*/

  /* USER CODE END 2 */

  /* Infinite loop */
  /* USER CODE BEGIN WHILE */
  while (1)
  {
    /* USER CODE END WHILE */

    /* USER CODE BEGIN 3 */
    /*printf("TIM4 CEN=%u CNT=%lu CCR1=%lu\r\n",
           (unsigned)((TIM4->CR1 & TIM_CR1_CEN) ? 1U : 0U),
           (unsigned long)__HAL_TIM_GET_COUNTER(&htim4),
           (unsigned long)__HAL_TIM_GET_COMPARE(&htim4, TIM_CHANNEL_1));*/

    //PS2_TypeDef pad;
    if (PS2_Scan(&pad))
    {
      /*PS2_PrintKeys(&pad);
      printf("stick: R%3u/%3u L%3u/%3u\r\n",
             pad.RJoy_LR, pad.RJoy_UD, pad.LJoy_LR, pad.LJoy_UD);*/
    }
    else printf("PS2 no data\r\n");
    HAL_Delay(200);
    //const int32_t test[]={0,50,100,150,-30,-100,-300};

    /*printf ("Hello STM32 | HCLK= %lu \r\n",(unsigned long) HAL_RCC_GetHCLKFreq());*/
    /*HAL_GPIO_TogglePin(GPIOC,GPIO_PIN_13);
    HAL_Delay(500);*/


  }
  /* USER CODE END 3 */
}

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
/* USER CODE BEGIN 4 */
int _write(int fd,char *buf,int len )
{
  HAL_UART_Transmit(&huart2,(uint8_t *)buf,(uint16_t)len,1000 );
  return len;
}
/* USER CODE END 4 */
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
