ZBC-QRLA/QRLA/docs/code/Inc/main.h

#define LED_Pin GPIO_PIN_13
#define LED_GPIO_Port GPIOC
#define KEY_Pin GPIO_PIN_0
#define KEY_GPIO_Port GPIOA
#define PS2_CMD_Pin GPIO_PIN_3
#define PS2_CMD_GPIO_Port GPIOB
#define PS2_CS_Pin GPIO_PIN_4
#define PS2_CS_GPIO_Port GPIOB
#define PS2_CLK_Pin GPIO_PIN_5
#define PS2_CLK_GPIO_Port GPIOB
#define PS2_DAT_Pin GPIO_PIN_9
#define PS2_DAT_GPIO_Port GPIOB
