ZBC-QRLA/QRLA/(commit log)

2026-10-02 新增docs文件夹和start
2026-10-02 新增了start-day的图片和参考文档
2026-10-03 大幅更新了格式，因为学会我看AI 的参考范例之后学会了很多编辑技巧
2026-10-03 很无聊的，强迫症地修改了几处高光
2026-10-19 中期考核上传
2026-10-19 代码示例上传
2026-10-19 测试代码上传
